limpkin/xt60_parallelizer/kicad/xt60_parallelizer.pdf

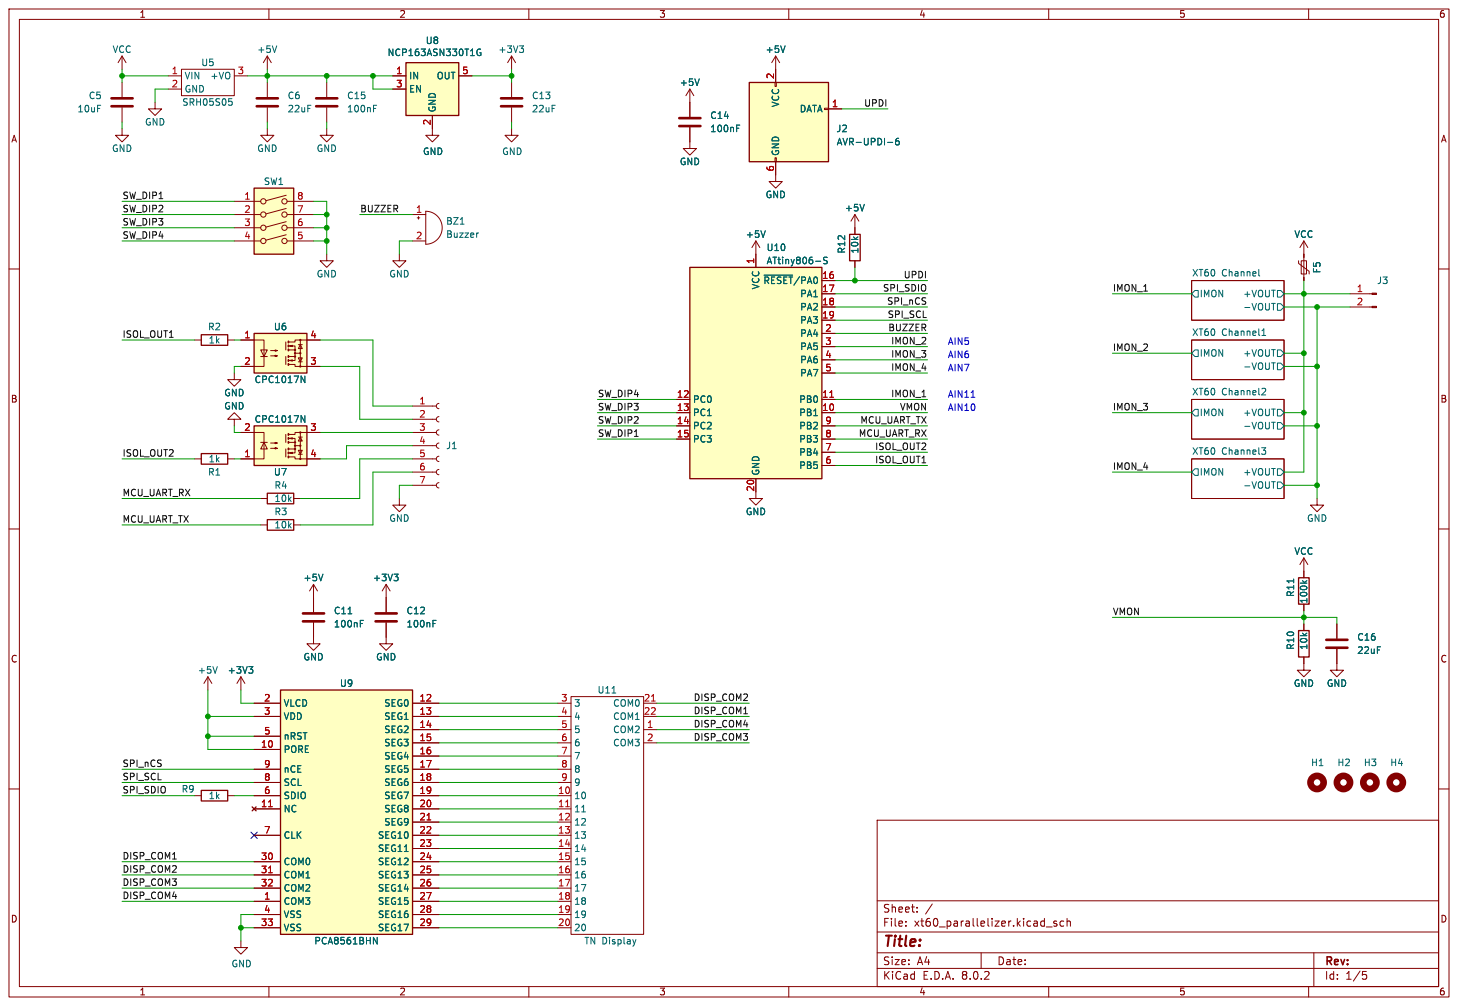
[picture p1: page 1]

J2AVR-UPDI-6 +5V GND GND GND

Id: 1/5 Title: File: xt60_parallelizer.kicad_sch Sheet: /

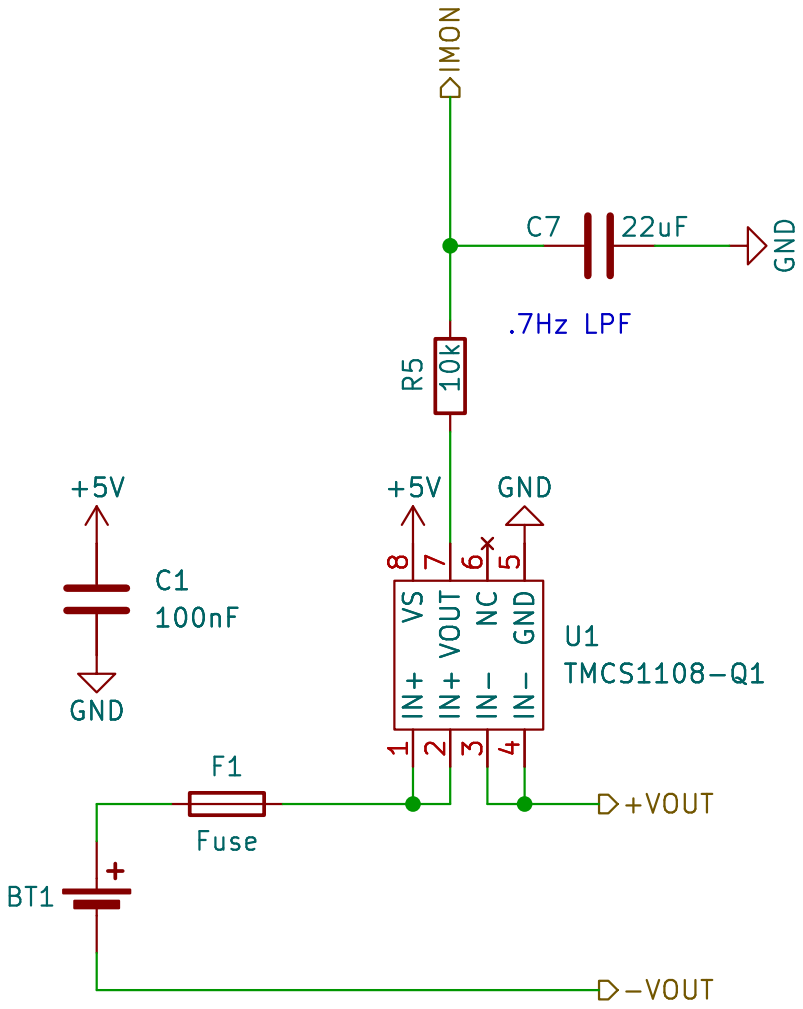
[picture p2: page 2]

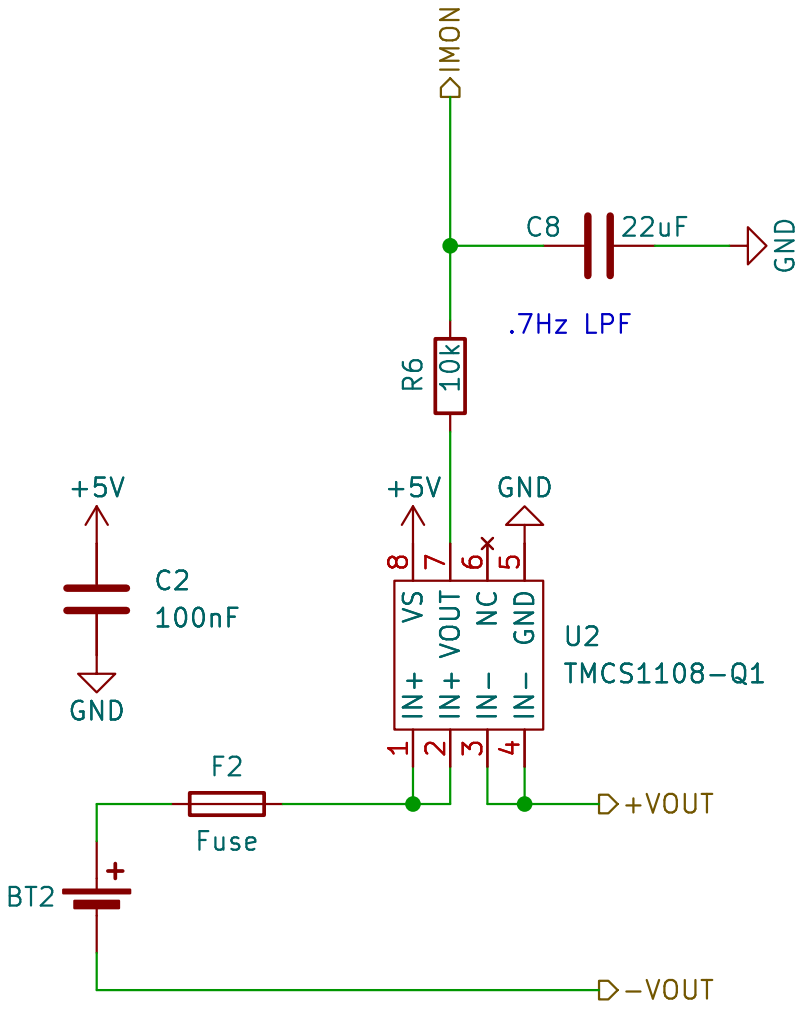
[picture p3: page 3]

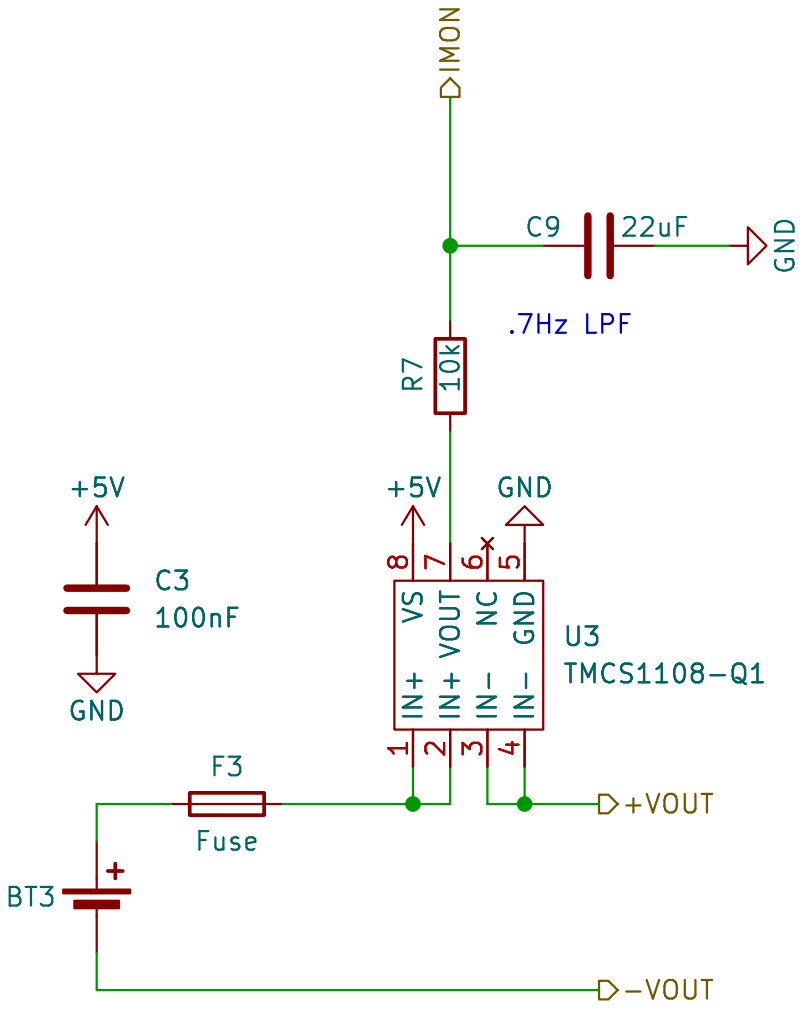
[picture p4: page 4]

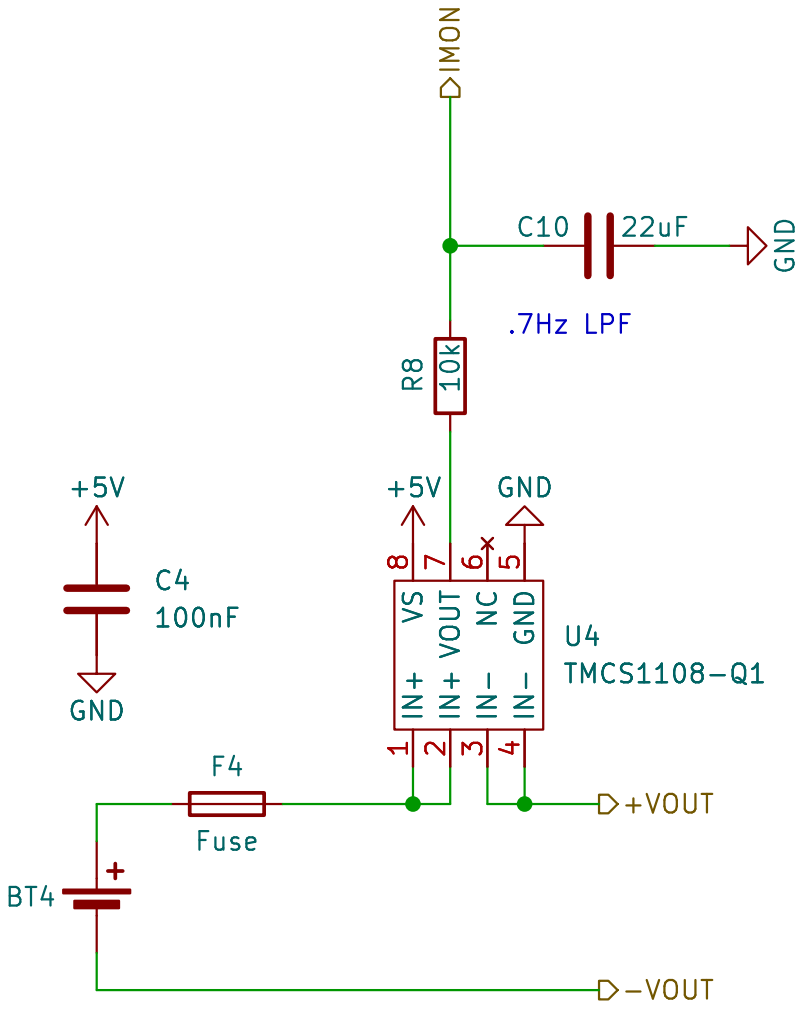
[picture p5: page 5]
