limpkin/xt60_parallelizer/kicad/xt60_parallelizer.kicad_pcb

## KiCad design kicad/xt60_parallelizer.kicad_pcb (2024-05-26)

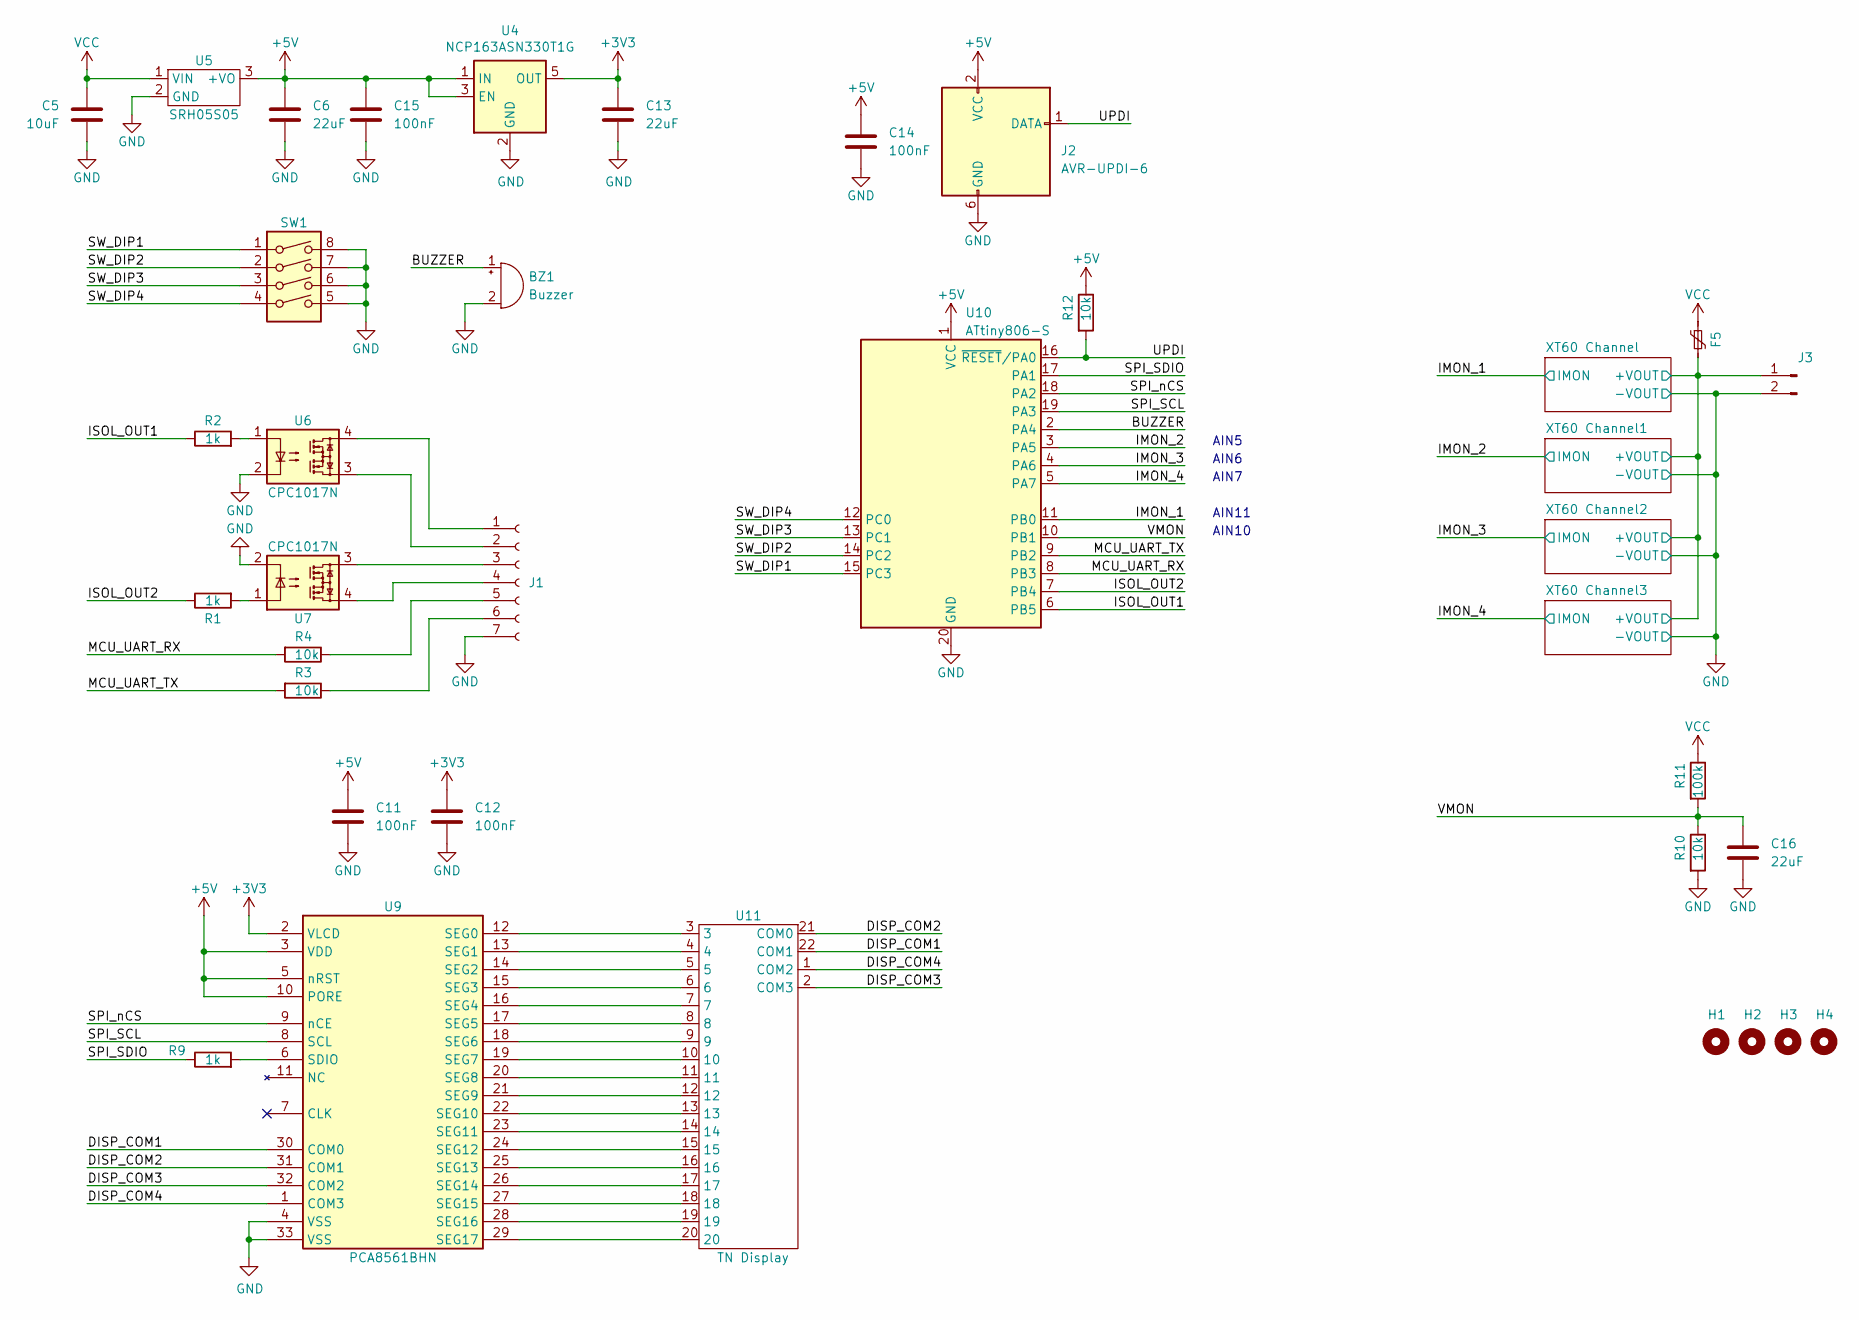
[picture p6: schematic xt60_parallelizer.kicad_sch]

Parts:
BZ1: Buzzer; 9042_ACTIVE_BUZZER
C5: 10uF; C_1210_3225Metric
C6, C13, C16: 22uF; C_0805_2012Metric
C11, C12, C14, C15: 100nF; C_0805_2012Metric
F5: Polyfuse_Small; Fuse_1812_4532Metric
H1, H2, H3, H4: MountingHole; MountingHole_3.2mm_M3
J1: Conn_01x07_Socket; PhoenixContact_PTSA_1x07_P3.5mm_Horizontal
J2: AVR-UPDI-6; IDC-Header_2x03_P2.54mm_Vertical
J3: Conn_01x02_Pin; XT60
R1, R2, R9: 1k; R_0805_2012Metric
R3, R4, R10, R12: 10k; R_0805_2012Metric
R11: 100k; R_0805_2012Metric
SW1: SW_DIP_x04; SW_DIP_SPSTx04_Slide_9.78x12.34mm_W7.62mm_P2.54mm
U4: NCP163ASN330T1G; SOT-23-5
U5: SRH05S05; SIP3_11.6x8.5mm_INV
U6, U7: CPC1017N; SOP-4_3.8x4.1mm_P2.54mm
U9: PCA8561BHN; QFN-32-1EP_5x5mm_P0.5mm_EP3.65x3.65mm
U10: ATtiny806-S; SOIC-20W_7.5x12.8mm_P1.27mm
U11: TN Display; 8DIGITS_TN

Connections:
/BUZZER: BZ1.1 (-), U10.2 (PA4)
/DISP_COM1: U9.30 (COM0), U11.22 (COM1)
/DISP_COM2: U9.31 (COM1), U11.21 (COM0)
/DISP_COM3: U9.32 (COM2), U11.2 (COM3)
/DISP_COM4: U9.1 (COM3), U11.1 (COM2)
/IMON_1: U10.11 (PB0); also elsewhere on the board
/IMON_2: U10.3 (PA5); also elsewhere on the board
/IMON_3: U10.4 (PA6); also elsewhere on the board
/IMON_4: U10.5 (PA7); also elsewhere on the board
/ISOL_OUT1: R2.1, U10.6 (PB5)
/ISOL_OUT2: R1.1, U10.7 (PB4)
/MCU_UART_RX: R4.2, U10.8 (PB3)
/MCU_UART_TX: R3.2, U10.9 (PB2)
/SPI_SCL: U9.8 (SCL), U10.19 (PA3)
/SPI_SDIO: R9.1, U10.17 (PA1)
/SPI_nCS: U9.9 (nCE), U10.18 (PA2)
/SW_DIP1: SW1.1, U10.15 (PC3)
/SW_DIP2: SW1.2, U10.14 (PC2)
/SW_DIP3: SW1.3, U10.13 (PC1)
/SW_DIP4: SW1.4, U10.12 (PC0)
/UPDI: J2.1 (DATA), R12.2, U10.16 (~RESET/PA0)
/VMON: C16.1, R10.1, R11.2, U10.10 (PB1)
unnamed: J1.1, U6.4
unnamed: J1.2, U6.3
unnamed: J1.3, U7.3
unnamed: J1.4, U7.4
unnamed: J1.5, R4.1
unnamed: J1.6, R3.1
unnamed: R1.2, U7.1
unnamed: R2.2, U6.1
unnamed: R9.2, U9.6 (SDIO)
unnamed: U9.12 (SEG0), U11.3
unnamed: U9.13 (SEG1), U11.4
unnamed: U9.14 (SEG2), U11.5
unnamed: U9.15 (SEG3), U11.6
unnamed: U9.16 (SEG4), U11.7
unnamed: U9.17 (SEG5), U11.8
unnamed: U9.18 (SEG6), U11.9
unnamed: U9.19 (SEG7), U11.10
unnamed: U9.20 (SEG8), U11.11
unnamed: U9.21 (SEG9), U11.12
unnamed: U9.22 (SEG10), U11.13
unnamed: U9.23 (SEG11), U11.14
unnamed: U9.24 (SEG12), U11.15
unnamed: U9.25 (SEG13), U11.16
unnamed: U9.26 (SEG14), U11.17
unnamed: U9.27 (SEG15), U11.18
unnamed: U9.28 (SEG16), U11.19
unnamed: U9.29 (SEG17), U11.20
VCC: C5.1, F5.1, R11.1, U5.1 (VIN)

Parts of its further copies:
U8: NCP163ASN330T1G; SOT-23-5

Notes on the sheet:
AIN10
AIN6
AIN11
AIN5
AIN7

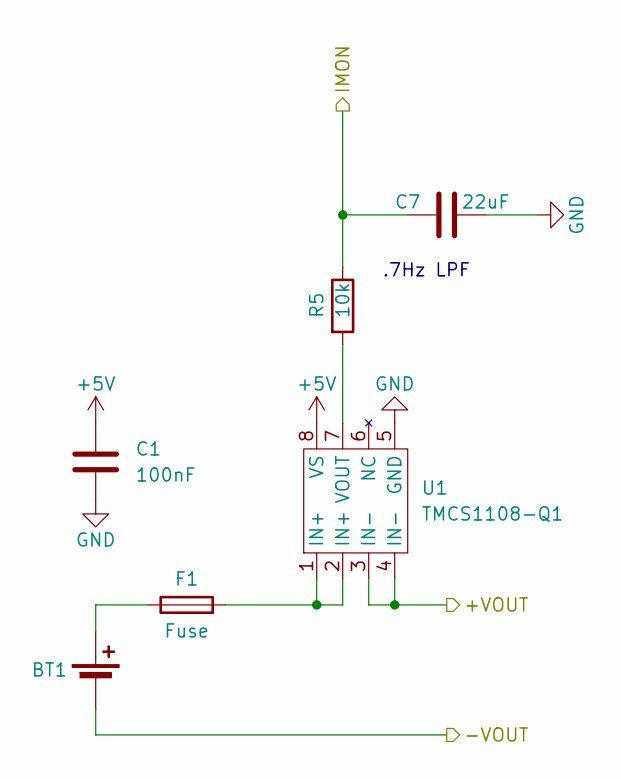
[picture p7: schematic xt60_channel.kicad_sch, XT60 Single Channel]

Parts:
BT1: Battery_Cell; XT60
C1: 100nF; C_0805_2012Metric
C7: 22uF; C_0805_2012Metric
F1: Fuse; Fuseholder_Clip-5x20mm_Keystone_3517_Inline_P23.11x6.76mm_D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
R5: 10k; R_0805_2012Metric
U1: TMCS1108-Q1; SOIC-8_3.9x4.9mm_P1.27mm

Connections:
/IMON_1: C7.1, R5.1; also elsewhere on the board
unnamed: BT1.1 (+), F1.1
unnamed: F1.2, U1.1 (IN+), U1.2 (IN+)
unnamed: R5.2, U1.7 (VOUT)

Parts of its further copies:
BT2, BT3, BT4: Battery_Cell; XT60
C2, C3, C4: 100nF; C_0805_2012Metric
C8, C9, C10: 22uF; C_0805_2012Metric
F2, F3, F4: Fuse; Fuseholder_Clip-5x20mm_Keystone_3517_Inline_P23.11x6.76mm_D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
R6, R7, R8: 10k; R_0805_2012Metric
U2, U3: TMCS1108-Q1; SOIC-8_3.9x4.9mm_P1.27mm

Connections of its further copies:
/IMON_2: C8.1, R6.1; also elsewhere on the board
/IMON_3: C9.1, R7.1; also elsewhere on the board
/IMON_4: C10.1, R8.1; also elsewhere on the board
unnamed: BT2.1 (+), F2.1
unnamed: BT3.1 (+), F3.1
unnamed: BT4.1 (+), F4.1
unnamed: F2.2, U2.1 (IN+), U2.2 (IN+)
unnamed: F3.2, U3.1 (IN+), U3.2 (IN+)
unnamed: R6.2, U2.7 (VOUT)
unnamed: R7.2, U3.7 (VOUT)
unnamed 40: R8.2; also elsewhere on the board

Notes on the sheet:
.7Hz LPF

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
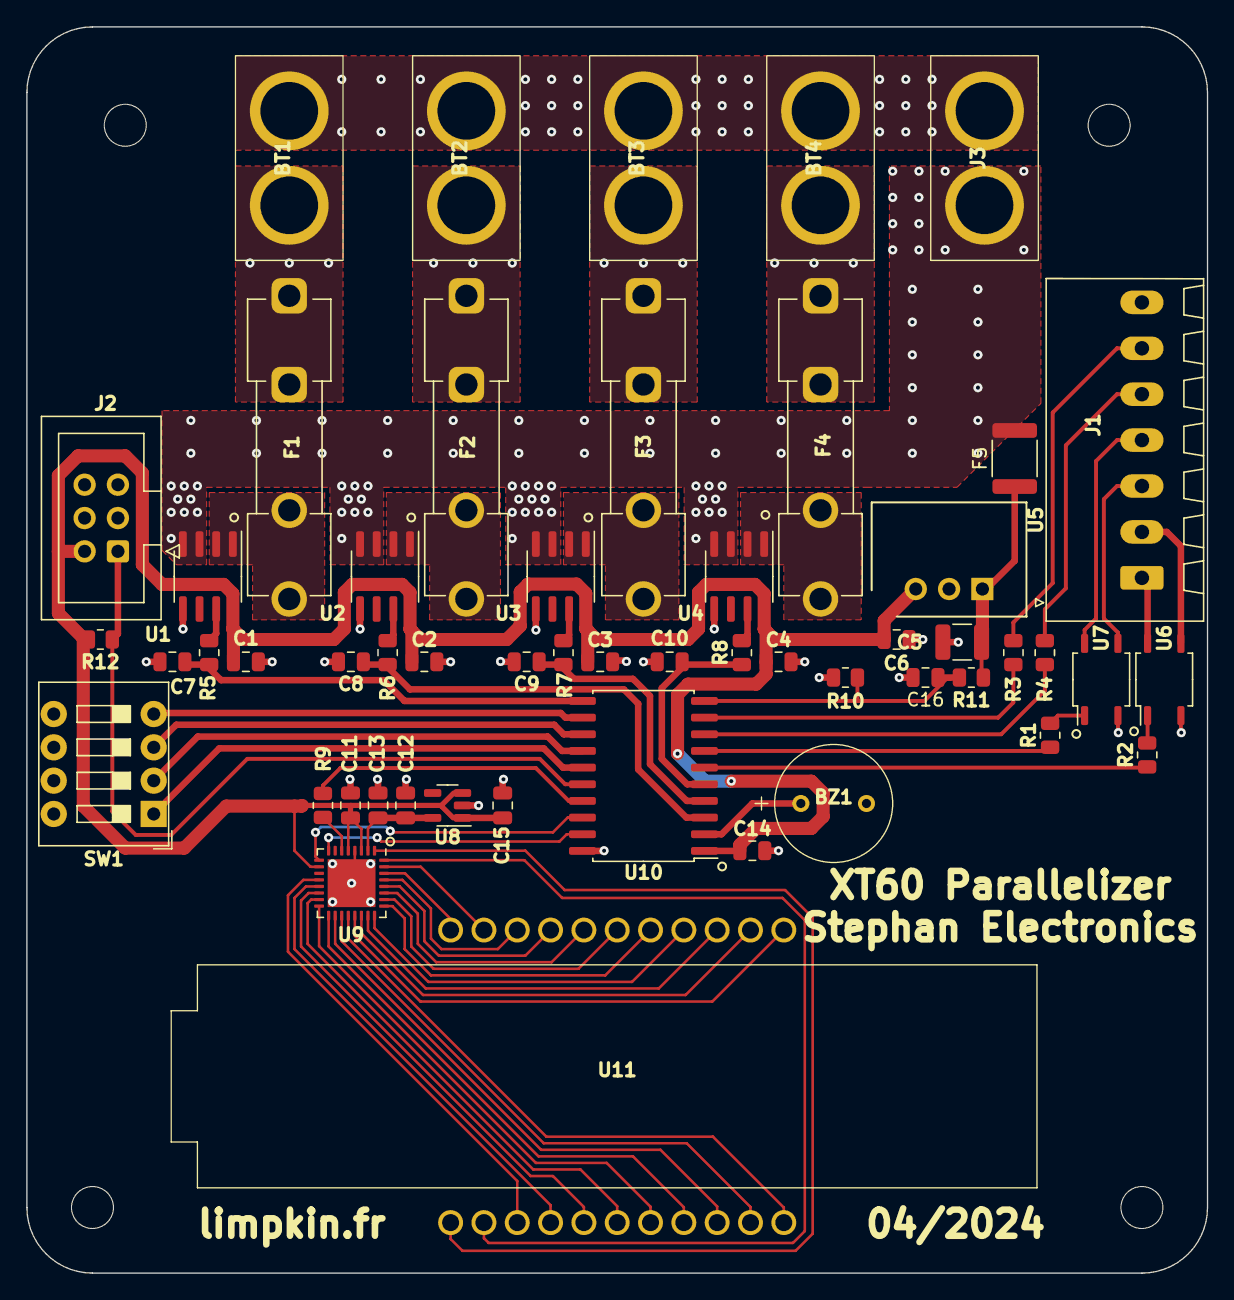
[picture p8: board xt60_parallelizer.kicad_pcb from above]

Board: 2 copper layers, 90.0 x 95.0 mm, 57 parts (0 on the bottom side), 66 nets.
