limpkin/xt60_parallelizer/firmware/XT60_balancer/ascii_lib.h

#ifndef ASCII_LIB_H_
#define ASCII_LIB_H_

#include <avr/pgmspace.h>

/*
 *  Project     Segmented LED Display - ASCII Library
 *  @author     David Madison
 *  @link       github.com/dmadison/Segmented-LED-Display-ASCII
 *  @license    MIT - Copyright (c) 2017 David Madison
 *
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
 */

const uint8_t SevenSegmentASCII[96] PROGMEM = {
	0b00000000, /* (space) */
	0b10000110, /* ! */
	0b00100010, /* " */
	0b01111110, /* # */
	0b01101101, /* $ */
	0b11010010, /* % */
	0b01000110, /* & */
	0b00100000, /* ' */
	0b00101001, /* ( */
	0b00001011, /* ) */
	0b00100001, /* * */
	0b01110000, /* + */
	0b00010000, /* , */
	0b01000000, /* - */
	0b10000000, /* . */
	0b01010010, /* / */
	0b00111111, /* 0 */
	0b00000110, /* 1 */
	0b01011011, /* 2 */
	0b01001111, /* 3 */
	0b01100110, /* 4 */
	0b01101101, /* 5 */
	0b01111101, /* 6 */
	0b00000111, /* 7 */
	0b01111111, /* 8 */
	0b01101111, /* 9 */
	0b00001001, /* : */
	0b00001101, /* ; */
	0b01100001, /* < */
	0b01001000, /* = */
	0b01000011, /* > */
	0b11010011, /* ? */
	0b01011111, /* @ */
	0b01110111, /* A */
	0b01111100, /* B */
	0b00111001, /* C */
	0b01011110, /* D */
	0b01111001, /* E */
	0b01110001, /* F */
	0b00111101, /* G */
	0b01110110, /* H */
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
	0b00000000, /* (del) */
};

#endif
